keresztesbeata/Solar-Tracker/README.md

# Solar-Tracker

Arduino Project for the "Design with Microprocessors" laboratory. 

Please refer to the [Documentation](https://github.com/keresztesbeata/Solar-Tracker/blob/main/Documentation.pdf) for more details.
