keresztesbeata/Solar-Tracker/Documentation.pdf

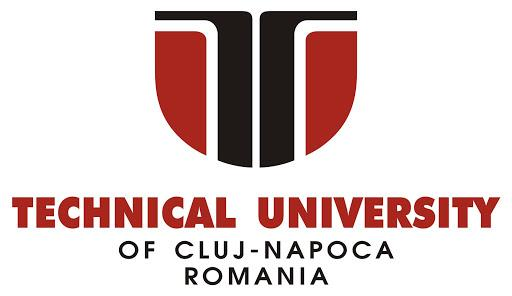
[picture p1: figure]

### Faculty of Automation and Computer Science

# Arduino Solar Tracker

### -Project prepared for the Design with Microprocessors Course-

### Student: Enoiu Diana, Keresztes Beáta, Fazakas Borbála Supervisor: Radu Dănescu Group 30432

2021-2022

# Background. Problem Statement

Due to the growing population and more and more industrialized societies, the energy requirements of humankind have drastically increased in the past century. Unfortunately, the primary energy sources that we relied on so far (coal, gas, petroleum, …) are not sustainable: their usage contributes to climate change, and some of them are even available only in a limited amount.

One of the most promising alternative energy resources is the Sun: an unlimited, renewable, environment-friendly energy resource, at least at first sight. However, for converting the solar energy into electrical power, we need a. photovoltaic cells and b. appropriate weather, with a good amount of light falling on the solar panels. It is evident that solar panels represent an alternative worth to be considered only in the sunny environments, but even there, it is an extra challenge to position the solar panels such that they reach their maximum potential. Ideally, the sunlight should fall perpendicularly on the solar panel to produce the maximum amount of energy.

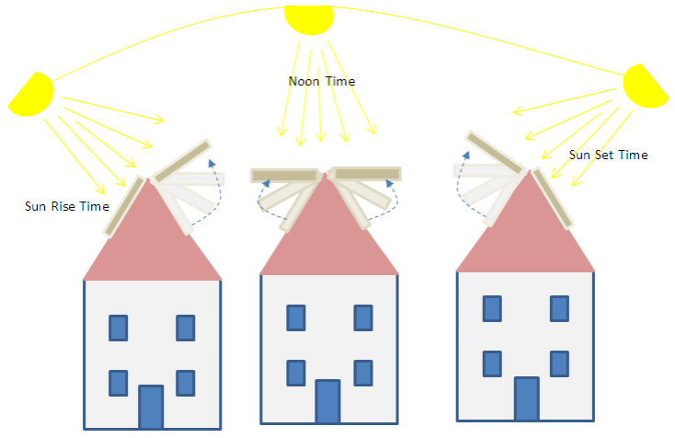
[picture p2: figure]

# The Goal of the Project

The goal of our project is to implement a system which automatically repositions a solar panel, depending on the position of the Sun, such that the amount of energy produced is always maximum.

# Design

We approached the problem from two different perspectives:

- The Sensor Mode: Firstly, we tried to come up with an algorithm that is based on the angle of the light rays falling on the solar panel. The objective of the algorithm is to position the panel such that the light rays are falling perpendicularly on it.
- Measurements:

■ to decide from which direction the light rays are falling, we used 4 photoresistors to measure the light intensity at the 4 sides of the solar panel
- Main concept:
■ the relative values of the light intensities define the direction into which the solar panel needs to be moved
- Output:
■ the position of two motors, which control the position of the solar panel, are adjusted according to the light intensities. The process is then repeated again from the measurements part, and the panel’s position is step-by-step adjusted to the optimal one.
- The Search Mode: Secondly, we developed an algorithm that works based on the voltage generated by the solar panel and tries to find the position where this voltage is maximal.
- Measurements:
■ the voltage generated by the solar panel in multiple positions is measured
- Main concept:
■ the position with the maximum voltage is selected as the optimal one
- Output:
■ the position of two motors, which control the position of the solar panel, are adjusted to reach the previously found optimal position

# The implementation

## The Hardware

### Components

- Arduino Mega microcontroller board
- Servomotors - https://cleste.ro/motor-servo-sg90-9g-180grade.html
- Used to make the panel movement. They can rotate up to 180 degrees and they operate with a voltage of 4.8 ~ 6.0V.
- Operating voltage: 4.8 ~ 6.0V
- Current: 0.19A@5V, 0.24A@6V
- Functioning speed: 0.12sec / 60 grade (4.8V) ~ 0.1 sec / 60 grade (6.0V)
- Temperature interval: -30 ~ + 60 ℃
- Dimension: 23X12.2X29MM
- Photoresistors - https://cleste.ro/fotorezistor-5528-ldr.html
- They measure the light intensities that are used in the sensor mode.
- Maximum voltage (V-dc): 150
- Maximum power consumption (mW): 100
- Temperature: - 30°C - +70°C
- Spectral value (nm): 540
- Light resistance (10Lux) (KΩ): 10 - 20

- Solar panel - https://cleste.ro/panou-solar-mini-5v-1-25-w-100mah.html
- The component that we try to make receive as much light as possible from the sun. The voltage obtained by the solar panel is also used when performing the search mode. The panel generates up to 5V
- Dimension 13.7cm x 8cm
- Operating voltage: 5V
- Operating current: 0-220mA
- Tilt-pan support - https://cleste.ro/suport-camera-cu-servomotor-pan-tilt.html
- Helped us with the mechanical part of the tilt-pan movement.
- Wires and resistors of 10K ohms (for the measurements of light intensities)

## Circuit design

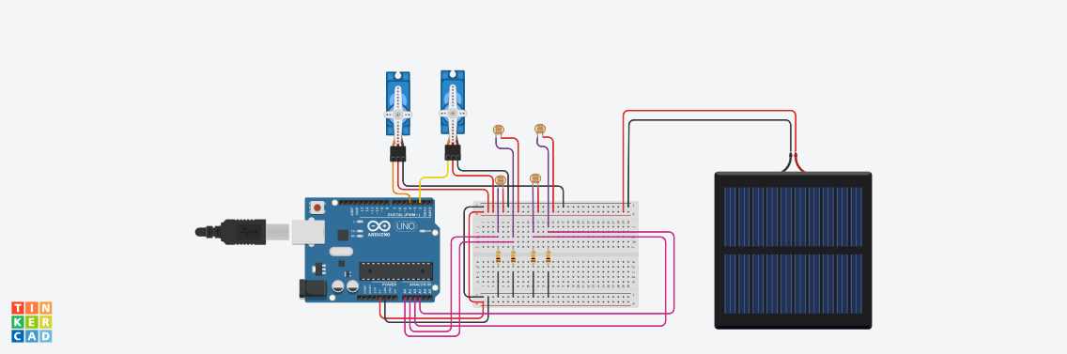
[picture p3: figure]

* The above circuit contains only the basic components for a functioning project. The complete diagram of the circuit with the components used for the interface, display and buttons, in order to interact with the user, can be found here: Interface .

### Schematic view

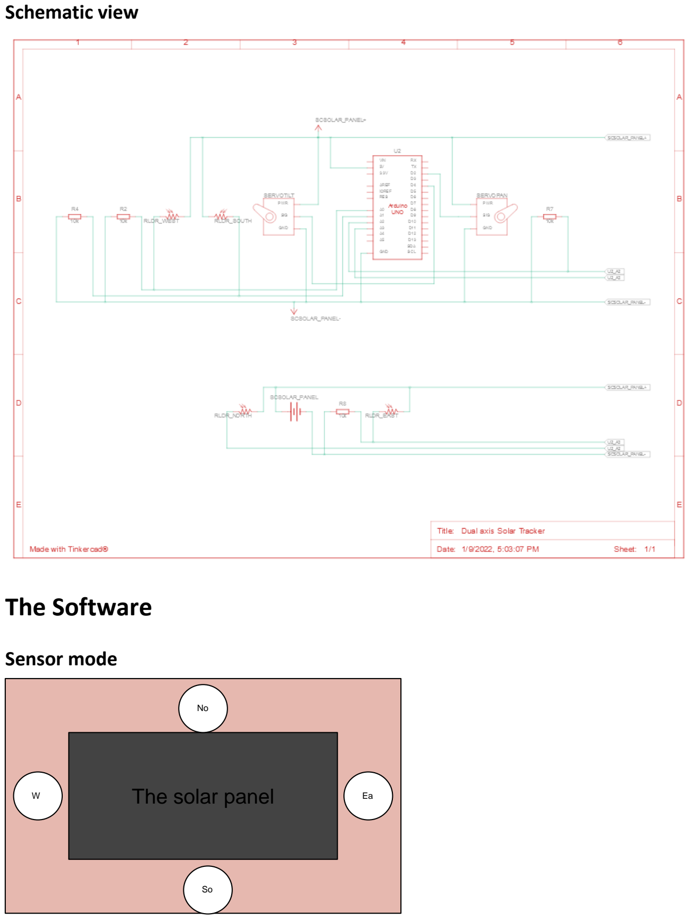
[picture p4: page 5]

## The Software

### Sensor mode

### The solar panel

No

So

W

Ea

The sensor mode in fact represents a hill climbing algorithm, in which the position where the light rays are falling perpendicularly on the solar panel is found step-by-step, by taking the local optimum (i.e. the step that brings the angle closer to 90 degrees) at each step. Fortunately, since there is only one light source to be considered, the Sun, meaning that there are no local maximums, just one global maximum, this greedy algorithm takes us to the global maximum after all.

To decide which direction the next step needs to be taken, we placed 4 photoresistors around the solar panel, 1 to the North, one to the East, 1 to the South and one to the West, as can be seen on the above picture.

The main idea is that the light rays are falling perpendicularly on the panel if and only if LightIntensityNorth = LightIntensitySouth and LightIntensityEast=LightIntensityWest.

Furthermore, if this optimal state was not yet reached, then the next action needs to be taken based on the following rules:

- if LightIntensityNorth > LightIntensitySouth, then move the panel to the North (i.e. upwards)
- if LightIntensityNorth < LightIntensitySouth, then move the panel to the South (i.e. downwards)
- if LightIntensityEast > LightIntensityWest, then move the panel to the East (i.e.to the right)
- if LightIntensityEast < LightIntensity, then move the panel to the South (i.e. downwards)

In practice, the perfect equality is almost impossible to reach, so we made the solar panel stop moving once the light intensities get close enough. Moreover, the magnitude of the step taken into a certain direction depends on the difference between the two light intensities causing that step: the higher the difference between the two of them, the larger the step should be.

Demo
For an example of how the Sensor Mode works, you may refer to the below figure (see the Data Acquisition section for a better understanding of how these plots were generated):

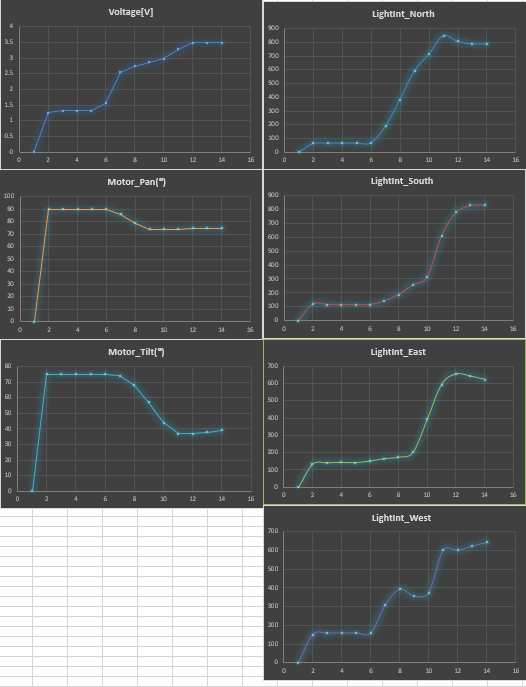
[picture p5: figure]

Disadvantages of the Sensor Mode:
As previously stated, the perfect equality between the corresponding light intensities can never be achieved. This makes it hard to detect the case when the motors should not be moved anymore. However, if the motors reposition themselves too often, then the efficiency of the model will decrease, as the motors use a significant amount of energy. As a workaround, we implemented the Search Mode too. For a perfect, efficient and ecological working mode, the Sensor and the Search modes should be used in turn.

### Search mode

The second mode that the solar panel uses to find the sun is Search Mode. This mode has two searches – broad search and restricted search.

Broad search measures the voltage value obtained by the solar panel in any direction and then it positions the solar panel to where the maximum voltage value was obtained. To position the panel in almost any possible direction, we first tilt the panel up (at 90 degrees from the ground) and then pan the panel from left to right, slowly incrementing the rotation angle that is sent to the servomotor. Once the left to the right movement is done, we will increment the tilt angle and then perform a right to the left movement (to avoid going back again to the left position, wasting energy and time). We should be able at the end of this algorithm to find an approximate position to where the maximum voltage value is and position the solar panel there.

After a broad search is completed, we will not use it anymore. Since we can assume that the sun does not change its position by a lot as time passes, we will use the restricted search. Restricted search does almost the same thing as broad search, but it does not go in any possible direction. Instead, it goes around the position where the maximum voltage was found to adjust the panel on small changes in the position of the sun. We can use restricted search from hour to an hour for example, but to exemplify the working of this search algorithm we will use it every 30 seconds.

The searching mode attempts to be a more economic mode compared to sensor mode. In sensor mode, the servo motors may continue to adjust the panel even after the maximum voltage position was found because the photoresistors will still measure changes in the position of the sun if it is cloud outside for example. Those small adjustments do not help increase the voltage obtained by the panel, but they waste some energy.

## Data acquisition

For visualizing the obtained data from the photoresistors and the solar panel, a Microsoft Excel extension tool was used, the PLX-DAQ, (https://www.parallax.com/package/plx-daq/) Parallax Data Acquisition Tool, which allows real-time monitoring of the read data and rendering them to a graph.

It allows communication with the Arduino board using the Serial interface. The Arduino board sends through the Serial line, on port 9600, the format of the columns as well as the actual data.

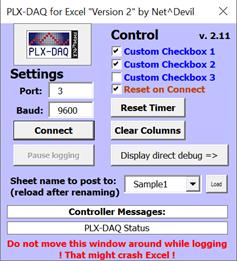
[picture p6: figure]

Seven charts were added for monitoring real-time the read values:

- Voltage: measured by the solar panel over time
- Motor_Pan and Motor_Tilt: which show the angles of the 2 motors for their current positions
- LightInt_North, LightInt_South, LightInt_East and LightInt_West: which illustrate how the intensity of the light changes depending on the orientation of the panel (towards the light or away from it), also they indicate the current direction of the light source (where the max value is measured).

An example of the collected data in the Sensor modes (from the 4 photoresistors and the solar panel):

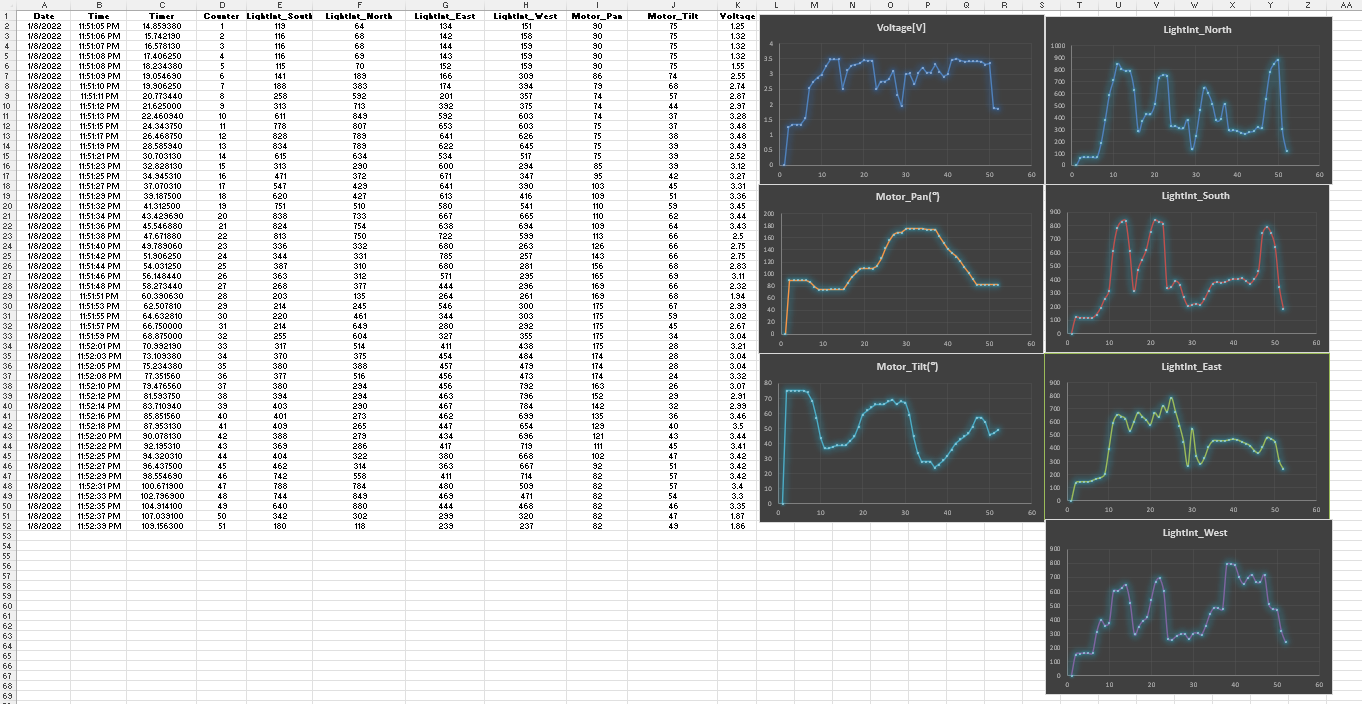
[picture p7: figure]

As the data comes from the Arduino board, through the Serial interface, the table is filled with the new data, and the plots automatically refresh showing the evolution of the measured quantities over time.

This allows us to visualize the recorded data and validate the correctness of our implementation, as well as it stores the received values in an excel file.

## Interface

To further extend the application, a user interface could be added to control the solar panel and to display its current working mode.

The interface consists of:

- LCD display: which displays the current functioning mode of the solar tracker, along with a small icon which represents the mode. These icons were created using custom characters.
- Buttons: a pair of buttons which allow switching from one working mode to another.

In order to instantly react to a button press, two interrupts were attached to the button pins, so that the corresponding interrupt handlers would be called to switch the mode. On such an event, the display is updated, showing the currently selected mode.

The interrupts attached to the buttons were necessary, because the main loop spends a lot of time and it is delayed considerably during the search mode, when it maps the space in all directions. Therefore, it might not react to a button press.

The design of the circuit is changed the following way after adding the 2 buttons and also the LCD display:

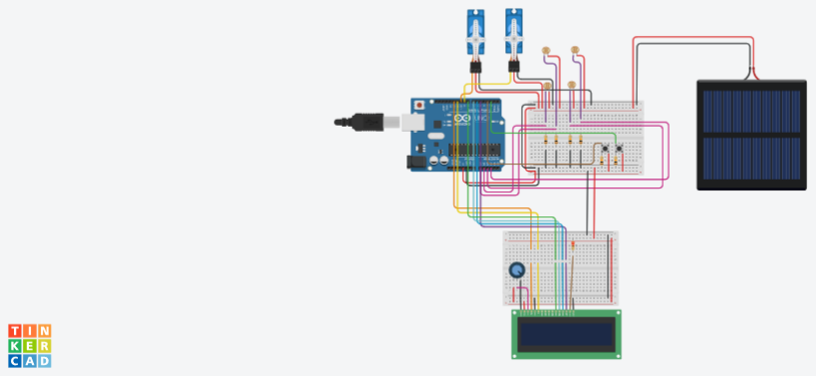
[picture p8: figure]

The board used in our project is an arduino Mega 2560, which has much more pins than an Uno board, it also has more external interrupt pins. However, in order to illustrate the schematic of the circuit on a simple Uno board, we can only attach external interrupts to two pins, namely 2 and 3. Therefore, the pins used for controlling the motors will be changed to pins 9 and 10, which are also pwm pins. An LCD display is attached to the circuit on the remaining pins.

In the project’s design we used an LCD shield, which was mounted directly on the pins of the arduino Mega board, instead of having to connect it with additional wires. The animations shown in each of the modes are the following:

- In the sensor mode:

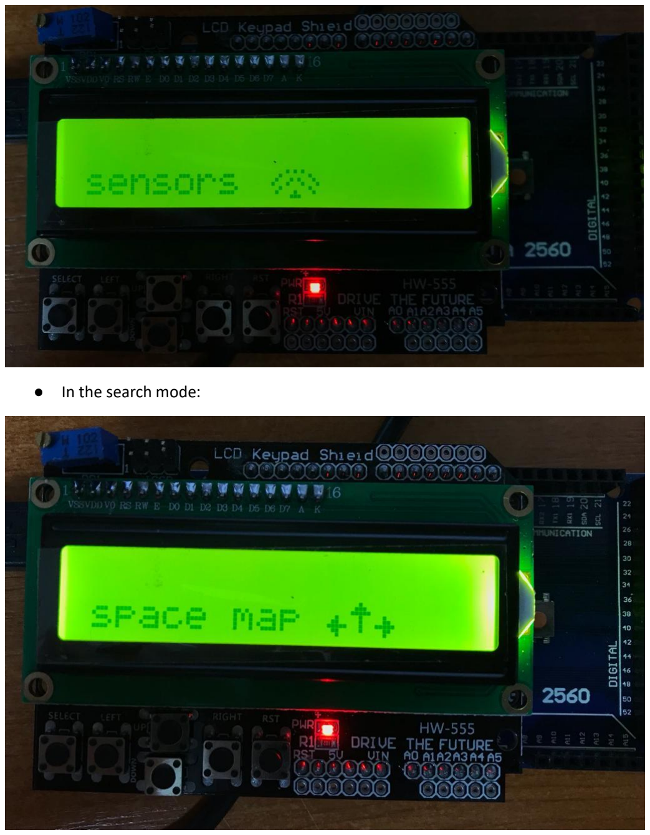
[picture p9: page 11]

- In the search mode:
