keresztesbeata/Solar-Tracker/(commit log)

2021-12-12 Panel movement in 4 dir based on sensor readings
2021-12-15 corrections for reading sensor data + refactor
    [solar_tracker_project.ino]
2021-12-22 daq result - add excel file with sample data of the hill climbing algorithm
    [DAQ_Solar_Tracker.xlsm]
2021-12-23 added graphs
    [DAQ_Solar_Tracker.xlsm]
2021-12-23 added measurement units
    [DAQ_Solar_Tracker.xlsm]
2022-01-05 resolve timing issues in search mode
    [solar_tracker_project.ino]
2022-01-05 fix bug in voltage plot - include all data points
    [DAQ_Solar_Tracker.xlsm]
2022-01-08 add example from Wednesday Mornibg to git
    [DAQ_Solar_Tracker - SensorMode - Example.xlsm]
2022-01-08 add sensor mode demo plots
    [DAQ_Solar_Tracker_Demo_SensorMode.xlsm]
2022-01-08 add sensor mode demo with voltage
    [DAQ_Solar_Tracker_Demo_SensorMode_WithVoltage.xlsm]
2022-01-15 rename excel datasheets
    [DAQ_Solar_Tracker - DataSheet - Template.xlsm, DAQ_Solar_Tracker - SensorMode - Example2 - MovingLightSource.xlsm, DAQ_Solar_Tracker_Demo_SensorMode.xlsm]
